ivvalmax/battery/Журнал разработки.docx

Журнал разработки

05.05.2026:

ClockConfigInit void clockInit(void);

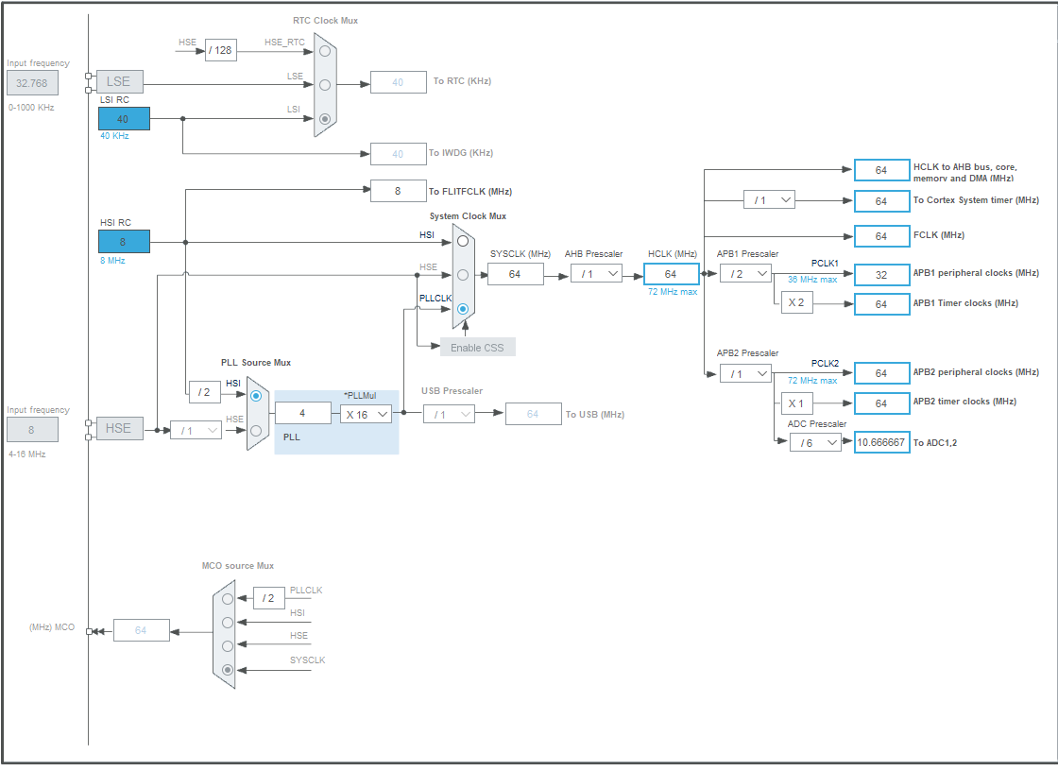
[picture p1: figure]

Clock control register (RCC_CR)

Clock configuration register (RCC_CFGR)

UART1 (transmit)

DMA

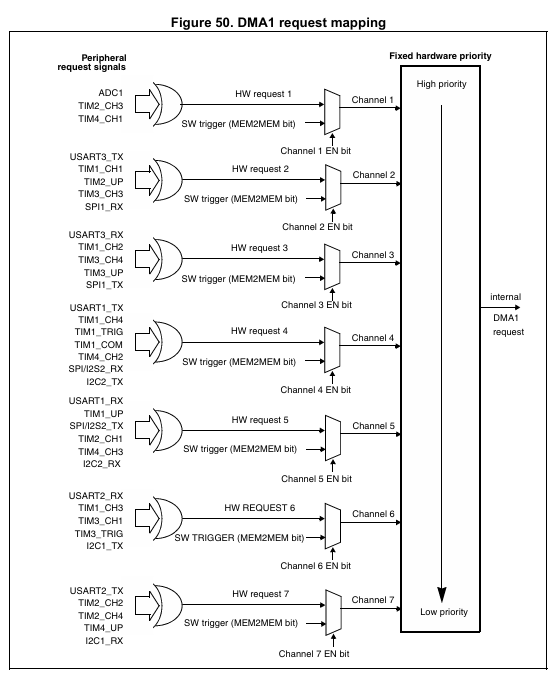
[picture p2: figure]
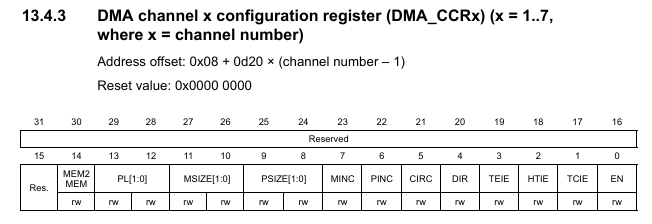
[picture p3: figure]

Прием сообщений

DMA>CCR |= CIRC
