ivvalmax/battery/Техническое_задание_на_разработку_системы_бесперебойного_питания.docx

УТВЕРЖДАЮ:

Директор ДРДС

АО «НИПК «Электрон»

____________________ Ефимов Д.В.

«_______» __________________ 2025 г.

Частное техническое задание

«Доработка системы бесперебойного электрического питания стойки управления в сборе АПР2-1030-01»

АПР2-1030-01 ЧТЗ

Согласование

Должность | ФИО | Дата | Подпись
Директор ДРТР | Боровских А.Н.
Руководитель отдела интеграции | Тетерин А.А.
Технический руководитель | Чен И.М.
Начальник отдела разработки платформенных решений | Ихсанов А.С.
Начальник конструкторского бюро | Головастов С.А.
Начальник отдела разработки ПО | Хорошилов Э.И.

ИСТОРИЯ ИЗМЕНЕНИЙ

Версия | Дата | Что изменилось | Автор
1.0 | 18.08.2024 | Черновик | Давыдов М.В.
1.1 | 21.08.2025 | Внесение изменений по замечаниям и уточнениям Д.В. Ефимова | Давыдов М.В.
1.2 | 09.09.2025 | Внесены изменения по замечаниям и уточнениям Д.В. Ефимова и Солпанова А.Л | Давыдов М.В

# Оглавление

# 1. Наименование, шифр, основание для выполнения работы. Исполнитель и сроки выполнения работ

  1.1 Наименование работы: «Доработка системы бесперебойного электрического питания стойки управления в сборе АПР2-1030-01».
  1.2 Шифр работы: «АПР2-1030-01»
  1.3 Основание работы: результаты опытной и промышленной эксплуатации легкого палатного аппарата, требования из технических условий на аппарат.
  1.4 Исполнитель работы – ДРТР.
  1.5 Заказчик работы – ДРДС.
  1.6 Сроки выполнения работы, этапы оговариваются в пункте 10 настоящего ЧТЗ.

# 2. Цель выполнения работы

2.1 Целью выполнения работы является:
a) Корректировка схемотехнических решений и конструкторской документации на систему электрического питания стойки управления легкого палатного аппарата в части обеспечения работоспособности аппарата от аккумуляторного и сетевого питания;
b) Обеспечение выполнение актуальных и перспективных требований безопасности;
c) Изготовление опытного образца легкого палатного аппарата с дорабатываемой системой электрического питания стойки управления;
d) Проведение проверок на систему электрического питания стойки управления легкого палатного аппарата с целью подтверждения требований данного технического задания;
e) Внедрение, по результатам проверок конструкторской документации, доработанной системы электрического питания в конструкторскую и рабочую документацию на стойку управления легкого палатного аппарата.

2.2 Назначение разрабатываемой системы

Система электрического питания предназначена для обеспечения бесперебойного питания стойки управления легкого палатного аппарата от двух источников питания:

a) Основной источник – однофазная сеть переменного тока ~220В, 50Гц;
b) Резервный источник - аккумулятор постоянного тока для потребителей из состава стойки управления.

Система должна обеспечивать время работы стойки управления от резервного источника питания с сохранением полного функционала не менее 2 часов при полном отсутствии основного источника. Система должна обеспечивать запуск и работу стойки управления от резервного источника электрического питания. При наличии основного источника система должна автоматически переключать питание стойки на основной источник питания. Система должна контролировать состояние резервного источника, осуществлять его заряд при наличии основного питания и обеспечивать защиту от аварийных режимов, а также обеспечивать передачу информации в систему управления (пульт управления WST-00-9450-01) о об уровне и состоянии заряда аккумулятора, наличии или отсутствии основного питания.

Управление включением, штатным выключением, аварийным отключением системы питания должно осуществляться органами управления типа механический ключ или аналогичными.

Система должна обеспечивать программно-контролируемое выключение с задержкой для безопасного завершения работы операционной системы устройства после получения команды выключения от органа управления (graceful shootdown).

# 3. Технические требования к системе электрического питания стойки управления

## 3.1. Общие требования

Основное электрическое питание стойки управления должно осуществляться от электрической сети переменного однофазного тока частотой 50 Гц, нормируемым напряжением 220 В, положительные и отрицательные отклонения напряжения в точке передачи электрической энергии не должны превышать 10 %.

Потребители из состава стойки управления легкого палатного аппарата основного электрического питания:

a) Преобразователь переменного однофазного тока частотой 50 Гц 220В в напряжение постоянного тока и подключаемая к нему нагрузка, включая: центральный вычислительный модуль аппарата (одноплатный компьютер) не менее 12 В (не более 24 В), мощность не более 30Вт; дозиметр контроля дозы ДРК-1М (12 ±1,2) В, потребляемая мощность не более 10Вт; монитор пульта управления легкого палатного аппарата 12В, потребляемая мощность 60Вт; маршрутизатор пульта управления легкого палатного аппарата 12-30 В, потребляемая мощность 21 В.
b) Модуль заряда литий-ионного аккумулятора резервного питания, потребляемая мощность до 250 Вт
c) Моноблок рентгеновский 220В до 2200 Вт (через систему электрического питания стойки управления осуществляется транзит силового питания моноблока).
d) Модуль заряда встроенного аккумулятора моноблока рентгеновского до 110Вт модель XVE126-5460200.

Резервное питание для потребителей из состава стойки управления должно осуществляться от литий-ионного аккумулятора.

Потребители из состава стойки управления легкого палатного аппарата резервного электрического питания:

a) центральный вычислительный модуль аппарата (одноплатный компьютер) не менее 12В (не более 24В), мощность не более 30Вт;
b) дозиметр контроля дозы ДРК-1М (12 ±1,2) В, потребляемая мощность не более 10Вт;
c) монитор пульта управления легкого палатного аппарата 12В, потребляемая мощность 60Вт;
d) маршрутизатор пульта управления легкого палатного аппарата 12-30 В, потребляемая мощность 21Вт.

При работе от основного электрического питания система должна обеспечивать защиту от перенапряжения сети - должна выдерживать кратковременные (до 1 мин) повышения напряжения до 275В. Система должна иметь защиту от длительных перенапряжений (отключение или ограничение).

При работе от основного электрического питания система должна обеспечивать защиту от пониженного напряжения сети: - должна осуществляться корректная работа при напряжении не ниже 198В. Рассмотреть возможность реализации отключения/перехода на основной источник при падении ниже 190В

В системе должна быть предусмотрена защита входных цепей. Должен быть предусмотрен плавкий предохранитель на входе сети внешнего электрического питания. Номинал 16А.

Система должна обеспечивать автоматическое переключение между основным и вспомогательным питанием. Время переключения на аккумулятор при пропадании основного электрического питания не более 20 мс, при переключении должно обеспечиваться сохранение работоспособности всех компонентов стойки управления. При появлении основного питания должен осуществляться возврат на него.

При работе от резервного источника питания предусмотреть возможность при отсутствии взаимодействия оператора с системой управления выхода в режим сниженного энергопотребления, например, настройкой выхода монитора в спящий режим при отсутствии взаимодействия с системой управления на время более чем 10 мин.

## 3.2. Основные компоненты системы электрического питания

Система электрического питания стойки управления должна включать в состав:

a) Неразборный сетевой шнур питания 220В, сечением не менее 1,5 мм2.
b) Входной фильтр электромагнитных и радиочастотных помех (EMI/RFI).
c) Преобразователь переменного однофазного тока частотой 50 Гц 220В в напряжение постоянного тока
d) Аккумулятор для потребителей из состава стойки управления.
e) Зарядное устройство аккумулятора для потребителей из состава стойки управления.
f) Зарядное устройство аккумулятора моноблока рентгеновского.
g) Контроллер (модуль) управления электрическим питанием стойки управления.
h) Органы управления системой электропитания для включения и выключения.
i) Элементы индикации системы электропитания (система индикации).

Обобщенная функциональная схема системы электрического питания приведена в Приложении 1.

## 3.3. Требования к аккумулятору для потребителей из состава стойки управления

Аккумулятор должен обеспечивать резервное питание стойки управления в течение времени не менее 120 минут. Емкость аккумулятора должна быть не менее 240 Вт·ч. Тип аккумулятора литий-ионный (Li-Ion) / литий-железо-фосфатный (LiFePO4)].

Аккумулятор должен иметь встроенную систему менеджмента аккумуляторных батарей (BMS), обеспечивающую балансировку заряда и предотвращающую преждевременный износ элементов.

## 3.4. Требования к контроллеру (модулю) управления электрическим питанием стойки управления

Контроллер (модуль) управления электрическим питанием легкого палатного аппарата должен:

- Осуществлять контроль состояния органов управления.
- Осуществлять контроль уровня заряда аккумулятора для потребителей из состава стойки управления.
- Производить измерение напряжения аккумулятора для потребителей из состава пульта управления с периодом опроса не реже 250 мс и точностью измерения с разрешением не хуже 20мВ. Определять уровень заряда (SC) аккумулятора на основе диапазона напряжений в привязке к модели выбранного аккумулятора (в процентах, точность не хуже ±10%). Опрашивать состояния зарядного устройства в части контроля процессов с аккумулятором (идет заряд, короткое замыкание, перегрев).
- Осуществлять коммутацию основного и резервного источников электрического питания.
- Управлять системой индикации
- Осуществлять информационное взаимодействие с центральным вычислителем стойки управления по цифровому интерфейсу.

3.4.1 Процедура включения/выключения

Таблица состояний 1.

Наличие 220В | Положение силового органа управления | Режимы стойки управления | | Статус Заряда аккумулятора | Работа стойки от аккумулятора или от напряжения, получаемого из сетевого питания | Индикация светодиодов
| | Режим аппарата | Нажатие кнопки
НЕТ | ВКЛ | Выключен Включен | Нажатие кнопки Нажатие кнопки | Не заряжается Не заряжается | Инициализация, запуск стойки, работа от аккумулятора Штатное выключение | Желтый светодиод «АКБ» - горит постоянно. В случае низкого уровня заряда менее 20 процентов – моргание светодиода. /Нет индикации Нет индикации
НЕТ | ВЫКЛ | Выключен | Нажатие кнопки | Не заряжается | Выключен – инициализация не происходит | Нет индикации
ЕСТЬ | ВКЛ | Выключен Включен | Нажатие кнопки Нажатие кнопки | Заряжается если уровень заряда меньше 100 процентов или нет неисправности Заряжается если уровень заряда меньше 100 процентов или нет неисправности | Инициализация, запуск стойки, работа от напряжения, получаемого из сетевого питания Штатное выключение | Зеленый светодиод «Сеть» - горит постоянно. Красный светодиод «Заряд» - светодиод горит постоянно, в случае ошибки аккумулятора, или аварии (КЗ, перегрев, ошибка зарядного устройства/контроллера) светодиод моргает. Нет индикации
ЕСТЬ | ВЫКЛ | Выключен | Нажатие кнопки | Не заряжается | Выключен – инициализация не происходит | Нет индикации

a) Процедура включения - при переводе двухпозиционного органа управления в положение ВКЛ и последующего нажатия кнопки без фиксации происходит инициализация системы питания, подается дежурное питание на контроллер управления, который проводит самодиагностику компонент системы и запускает питание на потребителей.
b) Процедура штатного выключения (Graceful Shutdown)

Нажатие кнопки без фиксации запускает формирование информационного сообщения в центральный вычислитель стойки управления.

Запуск таймера задержки `T_delay` = 300 с (конфигурируемый).

Ожидание информационного сообщения с подтверждением от вычислителя или прерывания по выставленному таймеру. Отключение питания с потребителей.

c) Аварийное отключение – перевод двухпозиционного органа управления в положение ВЫКЛ.

3.4.2 Информационное сопряжение по цифровому интерфейсу

В качестве физического интерфейса необходимо использовать RS232 или RS485.

Параметры интерфейса должны быть зафиксированы в протоколе информационного сопряжения. В рамках информационного сопряжения должны быть предусмотрены командные сообщения в контроллер управления, позволяющие запрашивать его текущее состояние, подтверждать готовность к выключению, устанавливать параметры (например, таймер плавного выключения) в контроллер управления, сбрасывать ошибки и т.д.

Со стороны контроллера должна производится отправка регулярного статуса с частотой сообщений не менее 2 сообщений в секунду. В составе сообщения статуса контроллера должна передаваться информация об уровне напряжения на аккумуляторе, статус заряда (активен/завершен/ошибка), информация о температуре, ошибки (перегрев, низкое напряжение на аккумуляторе, перегрузка, ошибка заряда, короткое замыкание, сработал таймер по плавному выключению, ошибка контрольной суммы и т.д.), запрос на снятие питания

Взаимодействие контроллера с прикладным ПО, разворачиваемым в вычислительном модуле, должно осуществляться через программный модуль. Модуль должен:

- Работать под управлением ОС Windows10 и выше.
- Поддерживать архитектуру.NET Framework или .NET 6/8.
- Поддерживать языки программирования: C#, C++/CLI, VB.NET и т.д.
- Интегрироваться в прикладное ПО EPOWXM
- Не завесить от стороннего ПО (все зависимости должны

распространяться в составе установочного пакета)

- Поддерживать следующий функционал API:
- Инициализация и открытие соединения с контроллером;
- Закрытие соединения;
- Чтение данных передаваемых с контроллера;
- Установка параметров в контроллер;
- Механизм callback-уведомлений;
- Логгирование

Для настройки и отладки контроллера программный модуль должен иметь сервисную утилиту, позволяющую отправлять командные сообщения в контроллер, устанавливать параметры для передачи в контроллер, отображать информацию, передаваемую из контроллера.

Утилита должна иметь:

- Графический интерфейс с областями/полями/вкладками для различных функций
- Значок статуса соединения
- Область визуализация передаваемых с контроллера параметров в реальном времени
- Терминал для отправки команд в формате hex/asci – в соответствии с протоколом
- Инструмент для записи лога.

## 3.5. Зарядное устройство аккумулятора для потребителей из состава пульта управления

Зарядное устройство аккумулятора, должно быть внешним компонентом или частью контроллера/модуля управления электрическим питанием.

Зарядное устройство должно обеспечивать алгоритм заряда аккумулятора. Для аккумуляторов типа LiFePO4 использовать алгоритм заряда аккумулятора CC/CV (Constant Current / Constant Voltage) — метод зарядки аккумуляторов, который предполагает сначала зарядку постоянным током, а затем — постоянным напряжением.

Обеспечивать и поддерживать ток заряда в соответствии с характеристиками аккумулятора.

Обеспечивать и поддерживать напряжение заряда в соответствии с характеристиками аккумулятора.

Прекращать заряд при достижении требуемых параметров или по настроенному таймеру (опционально).

Осуществлять защиту аккумулятора:

- От перезаряда;
- От переразряда;
- От переполюсовки;
- От короткого замыкания зарядных цепей;
- От перегрева.

## 3.6. Зарядное устройство аккумулятора моноблока рентгеновского

Зарядное устройство является поставляемым компонентом в составе моноблока рентгеновского. Характеристики и функционал зарядного регламентируется технической документацией на моноблок рентгеновский.

Запуск и функционирование зарядного устройства осуществляется при наличии основного источника питания

## 3.7. Органы управления системой электрического питания.

Органы управления системой электрического питания должен представлять из себя двухпозиционный механический ключ или двухпозиционную кнопку-переключатель и кнопку без фиксации.

Орган управления типа ключ должен иметь два положения, соответствующих:

a) Положение 0 (Выкл.) – линия внешнего сетевого питания разорвана, питание потребителей стойки управления заблокировано.
b) Положение 1 (Вкл) – подача внешнего сетевого питания разблокирована, подача питания потребителям стойки разблокирована.

Кнопка без фиксации – нажатие на нее должно обрабатываться контроллером в соответствии с Таблицей состояний 1.

## 3.8. Система индикации

Должна представлять из себя набор светодиодов, подключаемых к контроллеру управления электрическим питанием. Светодиоды должны устанавливаться на штативе аппарата, показания их должны считываться оператором. Использовать светодиоды из текущей реализации системы электрического питания стойки управления (APR2-10-0740 крышка с индикаторами).

Зеленый светодиод «Сеть» - горит постоянно при наличии основного электрического питания (при пропадании светодиод не горит).

Красный светодиод «Заряд» - светодиод горит при заряде аккумулятора. В случае ошибки аккумулятора, или аварии (КЗ, перегрев, ошибка зарядного устройства/контроллера) светодиод моргает.

Желтый светодиод «АКБ» - горит постоянно при работе от аккумулятора. В случае низкого уровня заряда менее 20 процентов – моргание светодиода.

## 3.9. Преобразователь переменного однофазного тока частотой 50 Гц 220В в напряжение постоянного тока

Формирование питание устройств от основного источника питания. Обеспечение гальванической развязки между сетью и стойкой управления – не менее 4000 В (основная изоляция).

## 3.10. Входной фильтр электромагнитных и радиочастотных помех (EMI/RFI)

Фильтр должен эффективно подавлять кондуктивные помехи как в направлении от сети к системе (помехи от сети), так и от системы в сеть (помехи, создаваемые системой). Параметры фильтра должны обеспечивать соответствие требованиям CISPR 11 Класс B (или выше) по кондуктивным помехам. Фильтр должен иметь встроенные разрядные резисторы для безопасного разряда конденсаторов X/Y после отключения от сети.

## 3.11. Неразборный сетевой шнур питания 220В

Многожильный (трехжильный) кабель с двойной изоляция, с сечением проводника не менее 1.5 мм2. На кабеле установлена штепсельный разъем типа CEE 7/7 на ток 16А.

## 3.12. Конструктивные требования

~~Компоненты системы электрического~~ ~~питания должны быть распределены в объеме~~ ~~конструктива~~ ~~легкого палатного аппарата~~

Основные компоненты системы должны монтироваться на плите APR2-10-0560. Компоненты системы, расположенные на плите APR2-10-0560, совокупно должны иметь габарит не более (высота/ширина/глубина) 360/457/79 мм.

На плите должны быть предусмотрены конструктивные элементы для установки компонент системы (DIN-рейки, стойки, кронштейны и т.д). Компоненты должны располагаться таким образом, чтобы обеспечить наиболее компактное расположение внутри стойки управления.

Для установки компонент системы на поверхности конструктива стойки управления, в частности для органов управления системы, элементов индикации, должны быть предусмотрены установочные отверстия, пазы и т.д.

Охлаждение компонентов системы электрического питания – должно осуществляться принудительно с помощью вентилятора типа ExeGate ExtraPower EP08015S2P 12В DC, 80x80x15 мм или аналогичного. В стойке управления должно быть предусмотрено место для установки вентилятора. Должны быть предусмотрены отверстия внутри стойки управления, обеспечивающие циркуляцию воздуха.

Монтаж компонентов системы электропитания должен осуществляться кабельными сборками с минимально необходимым количеством кабельных сборок. Должны быть предусмотрены конструктивные элементы, обеспечивающие фиксацию кабельных сборок к конструктиву легкого палатного аппарата. Электрический монтаж кабелей должен соответствовать требованиям ГОСТ 23584 (Монтаж электрический радиоэлектронной аппаратуры и приборов. Общие технические требования), ГОСТ 23594 (Маркировка). При наличии отклонений от указанных стандартов они оговариваются в КД.

В конструктиве стойки управления должно быть предусмотрено место под установку кабельного ввода для неразборного шнура питания. Кабельный ввод должен обеспечивать разгрузку от натяжения для неразборного шнура питания, выдерживать испытание натяжение 30Н и кручение 0.1Нм.

Вес составных частей системы электропитания должен быть не более 10 кг.

# 4. Требования к условиям эксплуатации, стойкости к внешним воздействиям

Система электропитания стойки управления и входящие в ее состав компоненты по условиям эксплуатации и внешним воздействиям должны соответствовать требованиям технических условий на аппарат, включая:

a) При эксплуатации должны быть устойчивы к воздействию климатических факторов по УХЛ 4.2 в соответствии с ГОСТ 15150.
b) При хранении должны быть устойчивы к воздействию климатических факторов для исполнения УХЛ 4.2 при условиях хранения 1 по ГОСТ 15150.
c) При транспортировании должны быть устойчивы к воздействию климатических факторов для исполнения УХЛ 4.2 при условиях хранения 5 по ГОСТ 15150.
d) Должны сохранять работоспособность при воздействии транспортной тряски по ГОСТ 26140.

# 5. Требования по безопасности

Система электрического питания стойки управления и входящие в ее состав компоненты по безопасности должны соответствовать требованиям технических условий на аппарат, включая:

a) Токоведущие цепи и токопроводящие части системы должны быть недоступны для случайного прикосновения в соответствии с требованиями ГОСТ Р МЭК 60601-1, подпункт 5.9.2.
b) Основная изоляция между частями, находящимися под напряжением 220 В, и доступными металлическими частями изделий, которые соединены с зажимом защитного заземления, должна выдерживать воздействие испытательного напряжения 1500 В соответственно, согласно требованиям ГОСТ Р МЭК 60601-1, подпункт 8.8.3.
c) Ток утечки на землю не должен превышать 5 мА в нормальном состоянии и 10 мА в условиях единичного нарушения.
d) ГОСТ Р МЭК 62133-2 Аккумуляторы и аккумуляторные батареи, содержащие щелочной или другие некислотные электролиты ТРЕБОВАНИЯ БЕЗОПАСНОСТИ ПОРТАТИВНЫХ ГЕРМЕТИЧНЫХ АККУМУЛЯТОРОВ И БАТАРЕЙ ИЗ НИХ ПРИ ПОРТАТИВНОМ ПРИМЕНЕНИИ Часть 2 Системы на основе лития
e) Система питания должна сохранять работоспособность и соответствовать требованиям к основным характеристикам (при воздействии следующих помех
- Электростатический разряд: ±8кВ**(контактный);
- Электрические быстрые переходные процессы: ±2кВ (напряжение сети), ±1кВ (сигнальные/управляющие линии);
- Повышения напряжения: ±2кВ (линия-линия), ±4кВ (линия-земля) на входе сети;
- Кондуктивные помехи, наведенные радиочастотными полями:3В RMS (от 150кГц до 80МГц);
- Радиочастотное электромагнитное поле:10 В/м (от 80МГц до 2.7ГГц).
- Магнитное поле промышленной частоты (50/60Гц): 30А/м.
- Провалы, кратковременные прерывания и вариации напряжения сети: провалы 0%, 40%, 70%, 80% на 0.5, 1, 5, 10 периодов (50Гц), прерывания на 250/300 периодов (5/6 сек).

# 6. Требования по надежности

Система электрического питания стойки управления и входящие в ее состав компоненты по надежности должны соответствовать требованиям технических условий на аппарат, включая:

a) Средняя наработка на отказ должна быть не менее 12500 циклов. Цикл, в общем случае, состоит из перемещения подвижных частей аппарата, установки допустимых значений параметров снимка, проведение диагностической процедуры с получением одного снимка. Число циклов в час – не более 20.
b) Средний срок службы системы должен быть не менее 6 лет. За критерий предельного состояния принимается невозможность или экономическая нецелесообразность восстановления работоспособности системы.

# 7. Технико-экономические требования

## 7.1. Стоимость системы электропитания не должна:

## a) превышать 25000 рублей (желательный вариант);

## b) превышать 43000 рублей (реалистичный - при условии, что на текущий момент стоимость системы электропитания оценочно составляет 34000 рублей)

## 7.2. Должны быть предусмотрены конструкторские и технологические мероприятия с целью максимального снижения стоимости системы электропитания

# 8. Требования к сырью, материалам и комплектующим изделиям межотраслевого применения

## 8.1. Перечни материалов, комплектующих изделий и элементов, применяемых в системе, должны удовлетворять требованиям настоящего ТЗ.

## 8.2. Применяемые комплектующие, материалы должны иметь действующие сертификаты соответствия требованиям действующих стандартов, санитарных норм.

## 8.3. Номенклатура марок и сортимента аналогов комплектующих изделий и материалов должна быть минимальной. Предпочтительно использовать комплектующие и материалы, ранее примененные в других изделиях предприятия.

## 8.4. При выборе покупных компонентов необходимо оптимизировать по критерию «минимальная стоимость из возможных для заданного уровня технических параметров»

## 8.5. Материалы, комплектующие изделия и элементы, применяемые в системе, должны быть подвергнуты входному контролю в порядке и объеме, установленном в инструкции по входному контролю.

# 9. Требования к маркировке

## 9.1. Маркировка должна производиться в соответствии с ГОСТ 26828. Состав и места маркировки должны быть указаны в КД.

## 9.2. Концы проводов, кабелей и жгутов должны иметь буквенную, цифровую или буквенно-цифровую маркировку. Ответные части одного и того же разъема должны иметь одинаковые обозначения. При этом кабельная часть разъема должна содержать в обозначении шифр того блока, где стоит ответная часть.

## 9.3. Размер шрифта должен выбираться по ГОСТ 26.008 и ГОСТ26.020.

## 9.4. Маркировка должна быть устойчивой в течение заданного срока службы, механически и климатически прочной и не должна стираться жидкостями, используемыми при эксплуатации, техническом обслуживании и ремонте.

# 10. Требования к выпускаемой документации

Для разрабатываемой системы электрического питания стойки управления, должна быть выпущена или скорректирована документация в объеме:

a) Схема электрических подключений для легкого палатного аппарата, с вложенной спецификацией на компоненты (APR2-00-0000-01 Э4).
b) Схемы электрические принципиальные на кабели. Перечни элементов на кабели. Сборочные чертежи на кабели. Спецификации на кабели.
c) Спецификации на кабельные сборки – часть кабельных сборок, входящих в структуру легкого палатного аппарата (APR2-00-0350, APR2-00-0340).
d) Конструкторская документация на контроллер управления.
e) Протокол информационного сопряжения контроллера управления

В эксплуатационные документы (руководство по эксплуатации, руководство оператора и т.д.) должна быть внесена информация об органах управления системой электропитания (включение, выключение, аварийное отключение и т.д.), индикация состояния системы электропитания и т.д.

# 11. Стадии и этапы и сроки разработки

Разработка и внедрение системы управления электрическим питанием легкого палатного аппарата должна включать следующие этапы и стадии:

a) Разработка и согласование технического предложения. Срок 2 недели
b) Разработка технического проекта, содержащего эскизную конструкторскую документацию в объеме, обеспечивающем изготовление опытного образца. Срок 2 недели
c) Изготовление опытного образца аппарата с внедренной системой электрического питания. Срок 4 недели
d) Проведение технических испытания на соответствие всем пунктам настоящего ЧТЗ. Срок 1 неделя.
e) Проведение мероприятий по устранению замечаний по результатам испытаний. Срок 1-2 недели.
f) Проведение мероприятий по включению системы электропитания в конструкторскую и технологическую документацию на легкий палатный аппарат. Срок 1 неделя

Настоящее ЧТЗ может уточняться и дополняться в процессе выполнения этапов разработки системы электрического питания стойки управления по согласованию сторон исполнителя и (или) заказчика.

# Приложение 1. Функциональная схема системы бесперебойного электрического питания стойки управления в сборе АПР2-1030-01

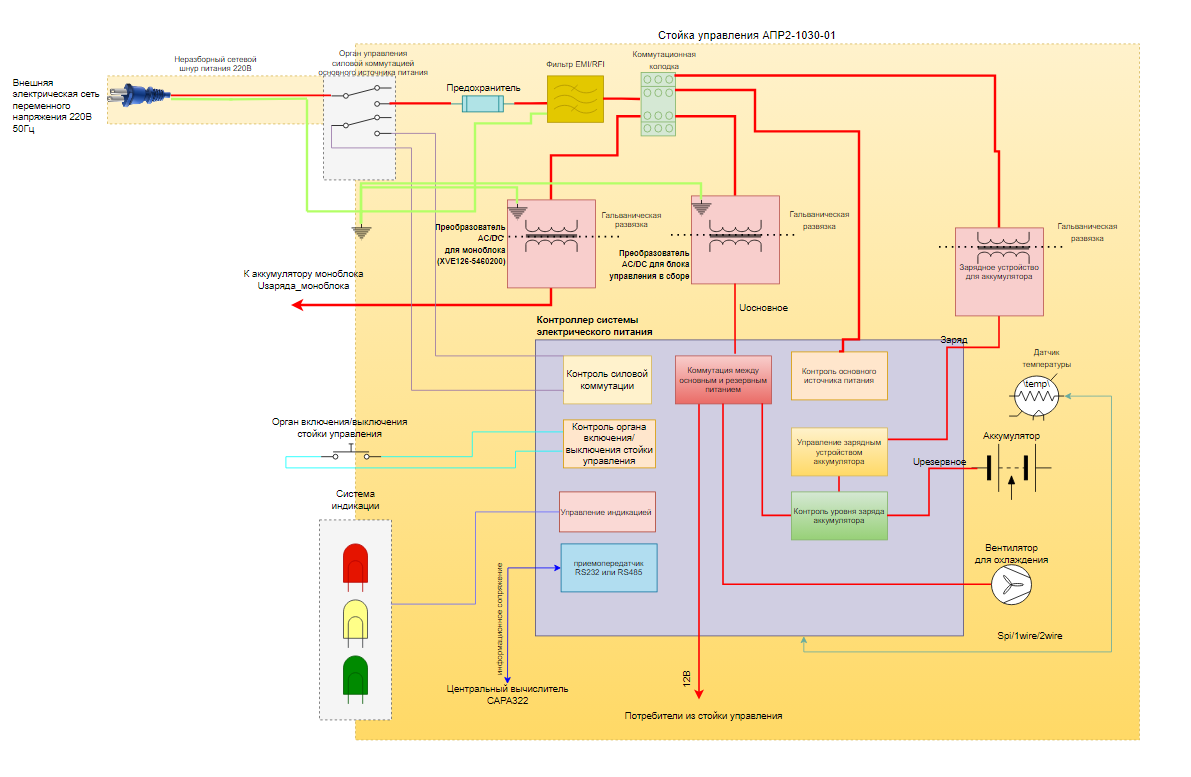
[picture p4: figure]

Частное техническое задание “Доработка системы бесперебойного электрического питания стойки управления в сборе АПР2-1030-01” 19 (19) АПР2-1030-01 ЧТЗ Конфиденциально Давыдов М. 18.08.2025 Версия: 1.2

Частное техническое задание “Доработка системы бесперебойного электрического питания стойки управления в сборе АПР2-1030-01” 1 (19) АПР2-1030-01 ЧТЗ Конфиденциально Давыдов М. 18.08.2025 Версия: 1.2
